Tguzman636/RLC-Multimeter/LTSpice FIles/measurement.asc

Cf: cap; 5p
L1: ind; 1432
Rf: res; 1Meg
Rz: res; 1Meg
U1: LT1028
U3: LT1122
Vss1: voltage; 15
Vss2: voltage; -15
X1: oscillator
Named nets: v_ss+, v_ss-, 0, v_out, v_x, v_y, v_0, v_90, v_in
.tran 0 150us 120us 1ns
