Tguzman636/RLC-Multimeter/LTSpice FIles/caps.asc

C1: cap; {C3}
C2: cap; {C2}
C3: cap; {C4}
C4: cap; {C5}
U1: ADG1401
U2: ADG1401
U3: ADG1401
U4: ADG1401
Vdd: voltage; 5
Vss: voltage; -5
Named nets: 0, vdd, vss, v_a, ve2, ve3, ve4, ve5
.param C5 1.311n
.param C4 15.73n
.param C3 159n
.param C2 1.59u
