Tguzman636/RLC-Multimeter/LTSpice FIles/ideal_oscillator.asc

V0: voltage; PWL REPEAT FOREVER (0 0 1ns 4 5000ns 4 5001ns 0 10us 0) ENDREPEAT
V1: voltage; PWL REPEAT FOREVER (0 0 2500ns 0 2501ns 4 7500ns 4 7501ns 0 10us 0) ENDREPEAT
Vsine: voltage; SINE 0 2 100k
Named nets: 0, v_sine, v_0, v_90
.tran 0 150us 100us
