Tguzman636/RLC-Multimeter/LTSpice FIles/oscillator.asc

R1: res; {R}
R2: res; {R}
R3: res; {R}
R4: res; {R}
R5: res; 500k
R6: res; 10k
U1: LT1028
U2: LT1028
U3: LT1028
U4: LT1028
U7: LT1016
U8: LT1016
Vin: voltage; 1µ
Vss1: voltage; 5
Vss2: voltage; -5
X1: caps
X2: caps
X3: caps
X4: caps
Named nets: v_ss+, v_ss-, 0, v_in, v_sq_0, v_sq_90, v_sine, ve5, ve4, ve3, ve2
.param R 1k
.tran 0 150us 100us
